twalter23/Beehivescale/Display/HW/Doc design/Photo proto boitier principal.jpeg

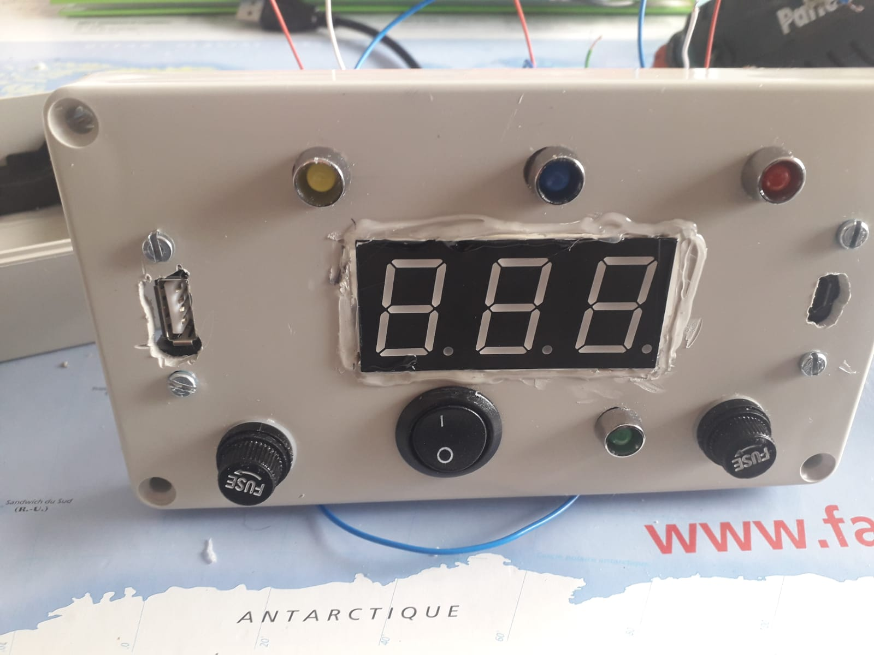
Display/HW/Doc design/Photo proto boitier principal.jpeg
