twalter23/Beehivescale/README.md

# BeehiveScale
Project of a scale for beehive.

The project is splited in two parts, the sensor and the display.
The sensor, also called pocket scale, is installed under the hive and will only be moved if the hive is deplaced. 

The display is a portative "box" with integrated battery and seven segments to display the weight of the hive.
A jack connector on display and sensor permits to connect them and start the communication. 

The sensor send the weight information to the display which set the seven segments accordingly to the received informations.
