twalter23/Beehivescale/Display/HW/Architecture + synoptique/Architecture protection BMS.pptx

µUSBB pour chargeur 5V (500m, 1A)

Protection
Surtension batterie (OVP)

Affichage
- 7 segments
- LED batterie faible
- LED ON

Protection
BMS

BMS
- Charge
- Gestion LED indication

Affichage
- LEDs statut charge

Batterie

Protection
Sous tension batterie (UVP)

X4 Gauge cell (pont de Wheatstone)

Presse étoupe

HX711

- Communication série
- Alimentation

DC/DC
5V

Arduino nano :
- Communication série avec boitier acquisition
- Affichage
- LED batterie faible

USB A

USB A

Arduino nano :
- Communication série avec boitier principal
- Stockage valeurs calibration HX711
- Communication série (émulation) avec HX711

Boitier principal

Boitier acquisition

## Slide 2

BQ2438x
Front end overvoltage and overcurrent protection
