twalter23/Beehivescale/Display/HW/Architecture + synoptique/Synoptique boitier principal.pptx

PANNEAU

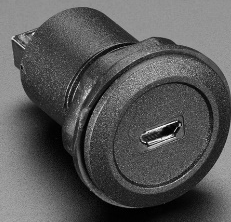
[picture p3: figure]

Socket µUSB B Charger
5V 1A

1A 5x20mm
Fuse IN

3 digits 7 segments display (+ bezel)

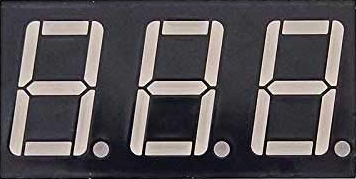
[picture p4: figure]
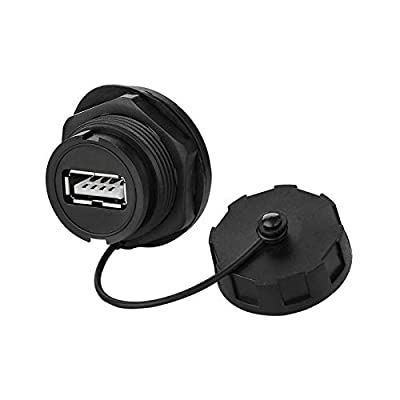
[picture p5: figure]

Socket USB A

ON

Batterie faible

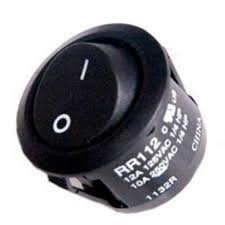
[picture p6: figure]

ON
OFF

200mA 5x20mm
Fuse OUT

En charge

Charge OK

## Slide 2

Connexions inter PANNEAU

CATH_DIG_2

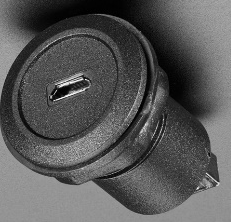
[picture p7: figure]

+5V_IN

+5V_FUSED

+SEG_1

+SEG_8

+5V_BOOST

GND

CATH_DIG_1

CATH_DIG_3

RX

TX

+5V_BOOST_FUSED

VBAT_ON

CMD_LED_CHARGE_OK

CMD_LED_ON

CMD_LED_EN_CHARGE

CMD_LED_BAT_FAIBLE

VBAT

+5V_SUPPLY
