twalter23/Beehivescale/Display/HW/Architecture + synoptique/Synoptique systeme complet.pptx

Boîtier principal :
Affichage, gestion de la batterie

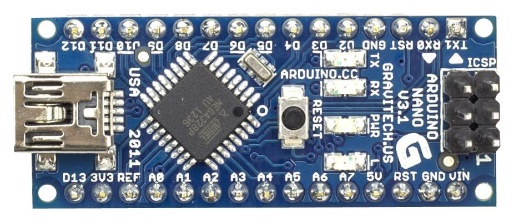
[picture p8: figure]

Comm. Série

Boîtier secondaire:
Un par jeu de capteur
Propre au jeu de capteur car contient les informations de calibration

Comm. Série
(émulée)

µ USB A
Socket

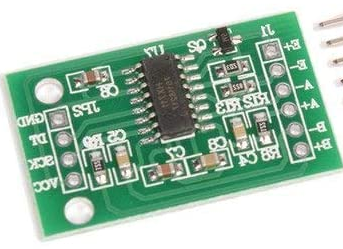
[picture p9: figure]

µ USB B
Socket

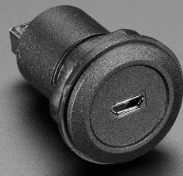
[picture p10: figure]

Câble USB A
mâle mâle
Alim et comm. série

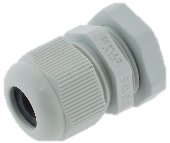
[picture p11: figure]

BMS

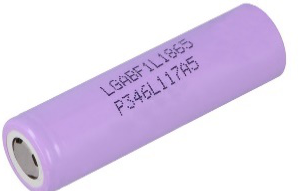
[picture p12: figure]

E+

A-

A+

E-
