twalter23/Beehivescale/Display/Fab/DAS acquisition ruche connectée.docx

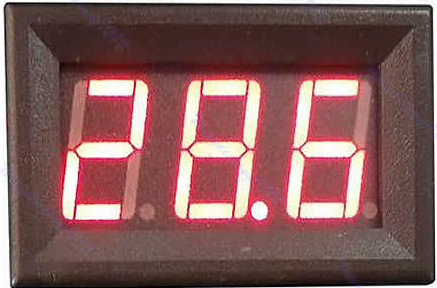
[picture p30: figure]
Hot Sell Tension Panel Meter 3Bit Affichage Numérique Voltmètre Mini 4.5-30V DC DEL
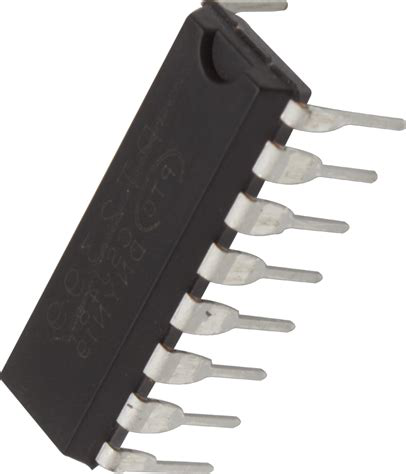
[picture p31: figure]
Integrated Circuit - PT2399, Echo / Delay | Amplified Parts
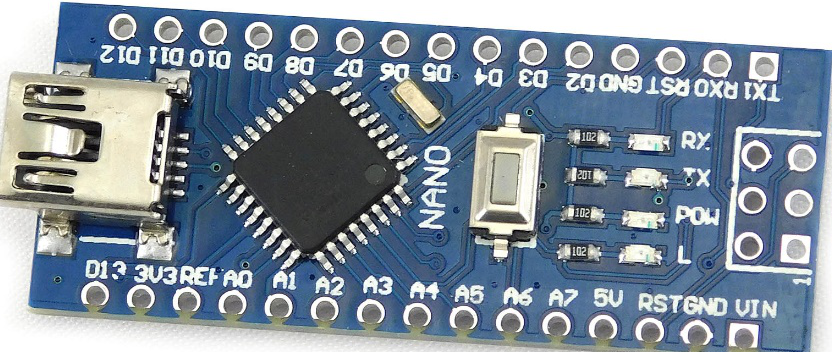
[picture p32: figure]
Nettigo: Klon Arduino Nano V3 ATMega328P + CH340
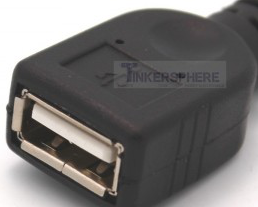
[picture p33: figure]
$3.49 - Female USB Port with Wire Leads - Tinkersphere
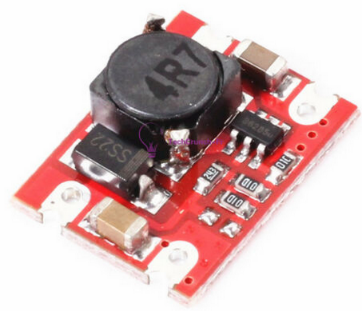
[picture p34: figure]
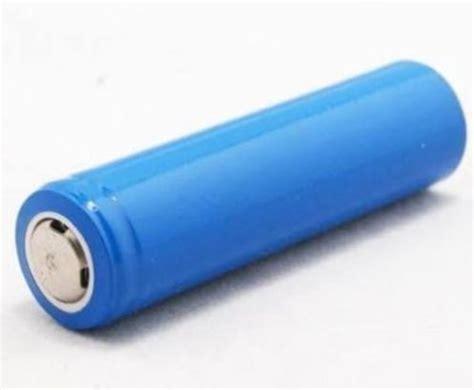
[picture p35: figure]
Lithium 18650 Rechargeable Cell, लिथियम रिचार्जेबल सेल ...
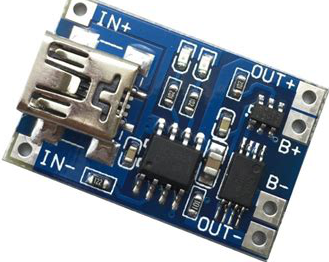
[picture p36: figure]
Other Electronic Components TP4056 1A 5V Lithium Battery ...
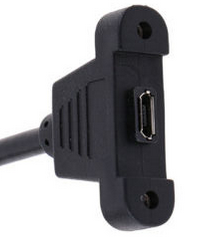
[picture p37: figure]
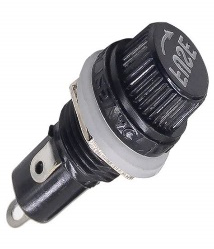
[picture p38: figure]
กระบอกฟิวส์ สำหรับฟิวส์ขนาด 5x20mm Fuse holder 5x20mm | SP ...
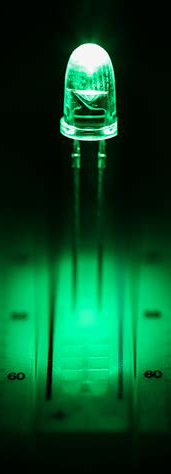
[picture p39: figure]
5mm Green LED - 525 nm - T1 3/4 LED w/ 8 Degree Viewing ...

SN74143
