twalter23/Beehivescale/Sensor/Fab/DAS Capteur.docx

## Perçage :

Presse-étoupe

Connecteur USB panel

## Intérieur du boîtier

6 fils

Connexion :

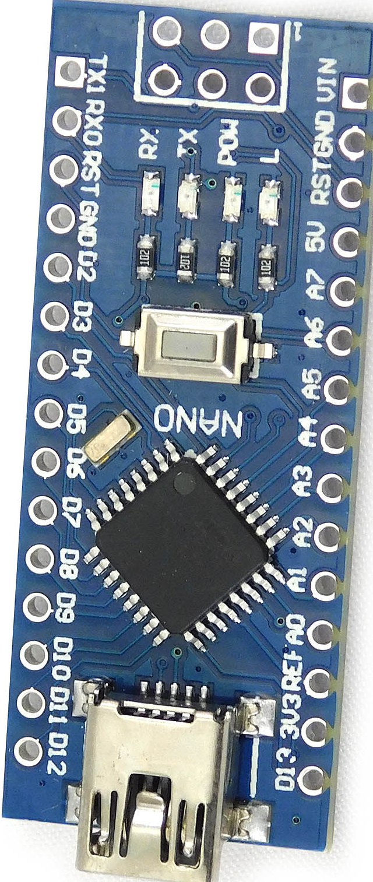
[picture p40: figure]
Nettigo: Klon Arduino Nano V3 ATMega328P + CH340
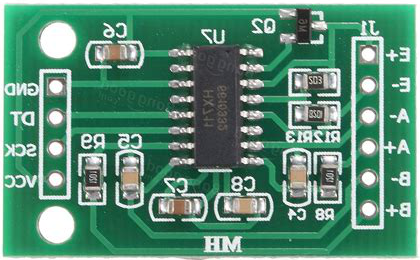
[picture p41: figure]
Buy Dual Channel HX711 Load Cell Amplifier Online at ...
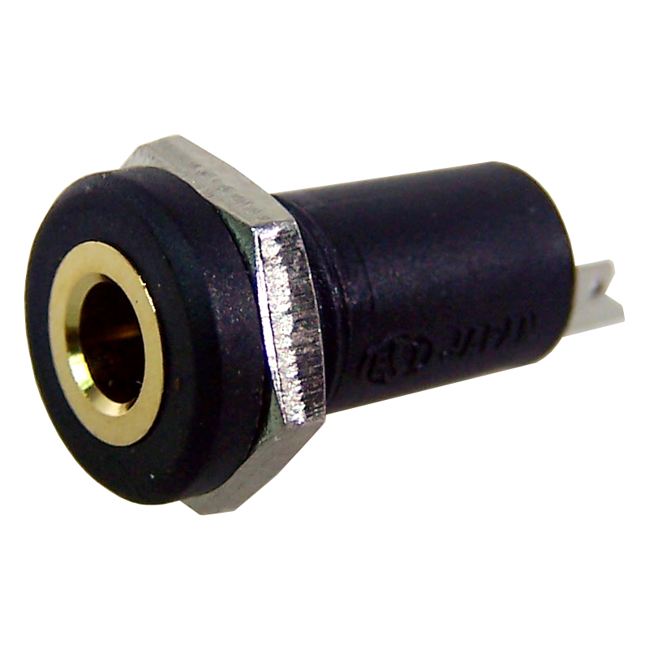
[picture p42: figure]
