twalter23/Beehivescale/Display/Meca/Boitier/PCB/Cotes boitier.docx

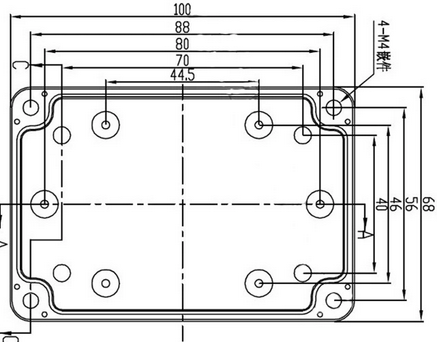
[picture p43: figure]

PCB :
