twalter23/Beehivescale/Display/HW/Doc design/Brochage Arduino.xlsx

Broche | Fonction | Signal
1 | D1/TX | RX
2 | D0/RX | TX
3 | RESET\
4 | GND | GND
5 | D2 | DIG1_BASE
6 | D3 | DIG2_BASE
7 | D4 | DIG3_BASE
8 | D5 | SEG_1
9 | D6 | SEG_2
10 | D7 | SEG_3
11 | D8 | SEG_4
12 | D9 | SEG_5
13 | D10 | SEG_6
14 | D11 | SEG_7
15 | D12 | SEG_8
16 | D13 | CMD_LOW_BAT
17 | 3V3
18 | AREF
19 | A0
20 | A1
21 | A2
22 | A3
23 | A4
24 | A5
25 | A6
26 | A7
27 | +5V | +5V_BOOST
28 | RESET\
29 | GND | GND
30 | VIN
