twalter23/Beehivescale/Display/HW/Doc design/Brochage connecteur carte principale.xlsx

Broche | Signal
1 | +5V_FUSED
2 | LED_EN_CHARGE
3 | LED_CHARGE_OK
4 | LED_LOW_BAT
5 | +5V_BOOST
6 | DIG1
7 | DIG2
8 | DIG3
9
10 | GND
11 | +SEG_A
12 | +SEG_B
13 | +SEG_C
14 | +SEG_D
15 | +SEG_E
16 | +SEG_F
17 | +SEG_G
18 | +SEG_H
19 | RX
20 | TX
