twalter23/Beehivescale/Display/SW/Flowchart code.pdf

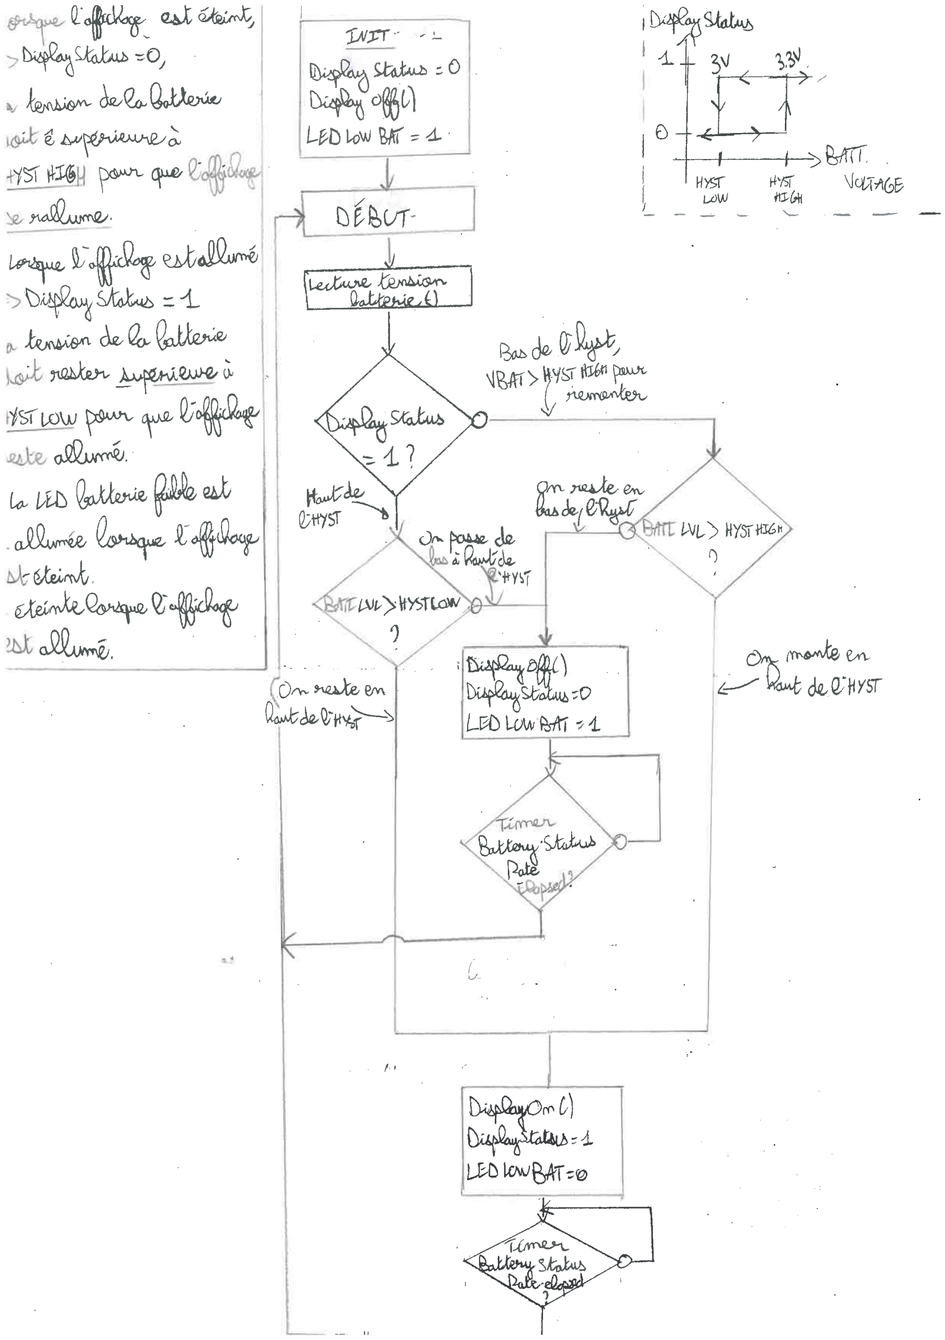
[picture p44: page 1]
