twalter23/Beehivescale/Display/Doc/Photos/Photo 2/WhatsApp Image 2021-04-11 at 21.18.06.jpeg

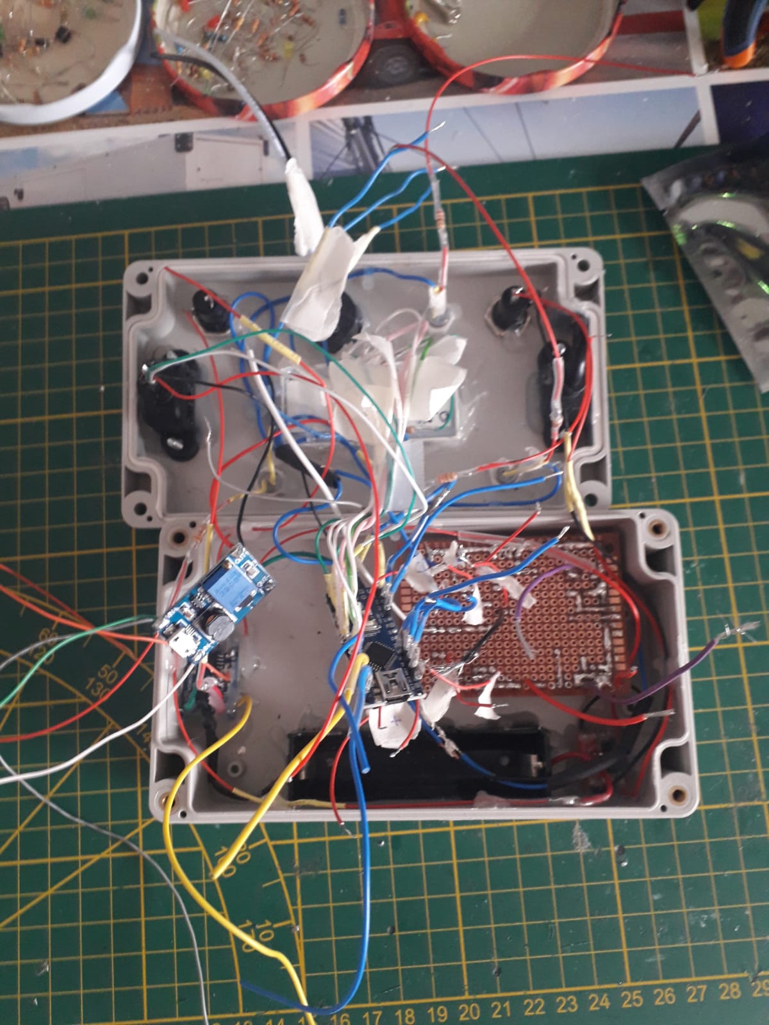
Display/Doc/Photos/Photo 2/WhatsApp Image 2021-04-11 at 21.18.06.jpeg
