twalter23/Beehivescale/Display/Doc/Photos/WhatsApp Image 2021-03-26 at 11.25.21.jpeg

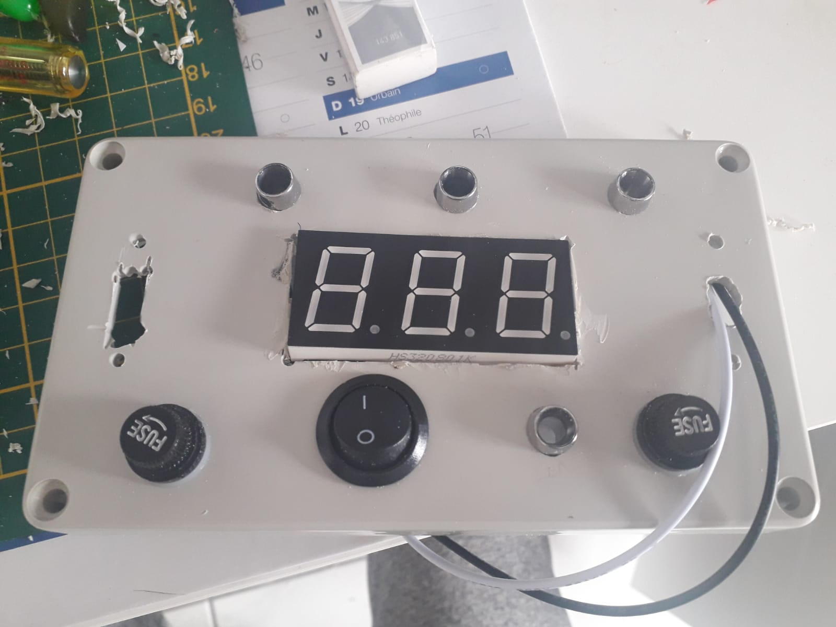
Display/Doc/Photos/WhatsApp Image 2021-03-26 at 11.25.21.jpeg
