twalter23/Beehivescale/Display/Doc/Photos/WhatsApp Image 2021-03-26 at 17.11.53(1).jpeg

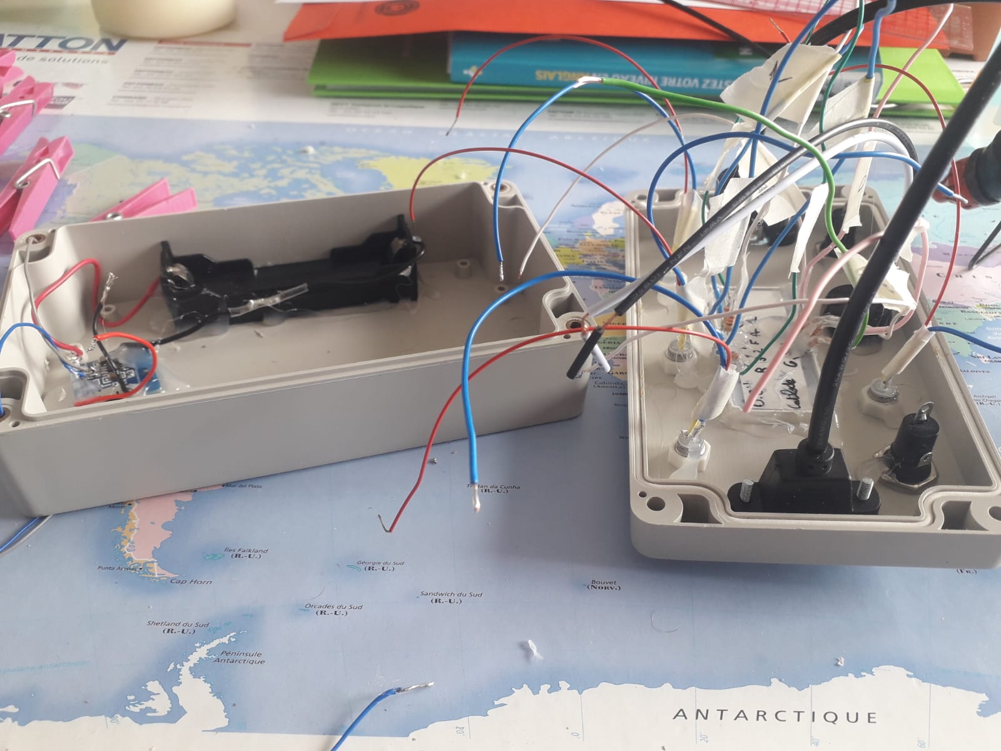
Display/Doc/Photos/WhatsApp Image 2021-03-26 at 17.11.53(1).jpeg
