twalter23/Beehivescale/Display/Fab/Bezel/WhatsApp Image 2021-04-18 at 17.24.22.jpeg

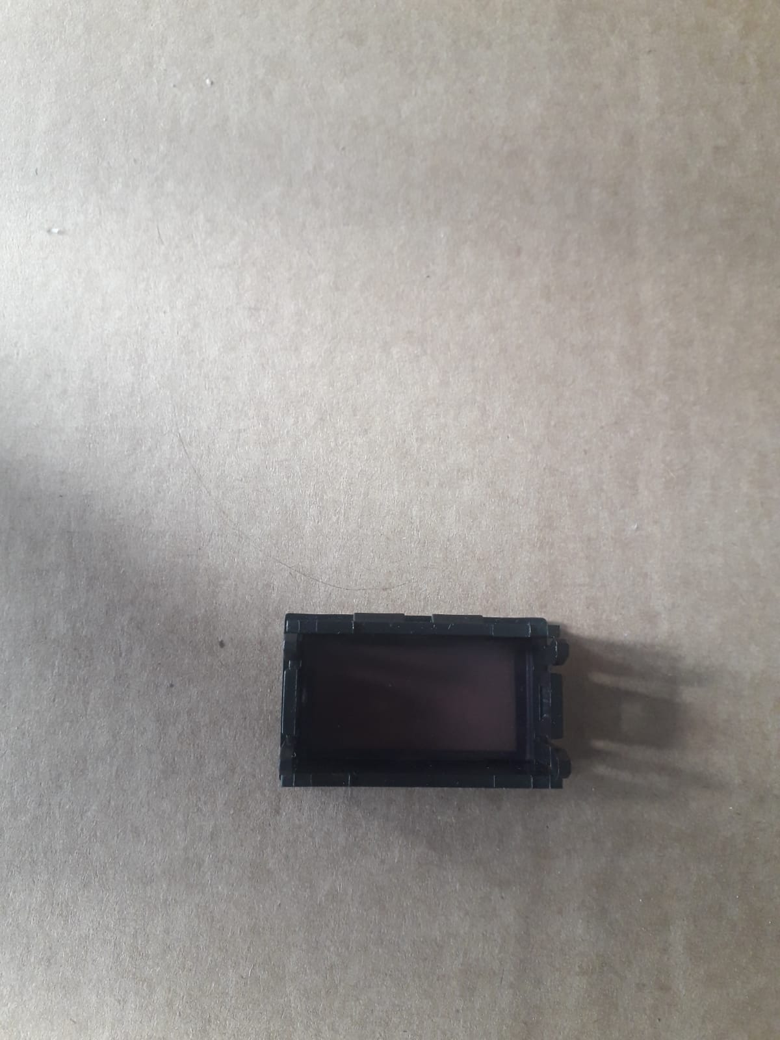
Display/Fab/Bezel/WhatsApp Image 2021-04-18 at 17.24.22.jpeg
