twalter23/Beehivescale/Display/Fab/BOM Acquisition ruche connectée.xlsx

Element | Ref | Fab | Lien | Quantité | Prix unitaire | Prix total
Boite 158mmx90mmx48mm |  |  | https://www.ebay.fr/itm/Plastique-Electrical-Bo%C3%AEtier-Bo%C3%AEte-De-Jonction-%C3%89tui-158mmx90mmx48mm-Gris/392008505112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 | 1 | 9.00 € | 9.00 €
Nano arduino |  |  | https://www.ebay.fr/itm/MINI-USB-Nano-V3-0-ATmega328P-CH340G-5V-16M-Micro-controller-Board-Arduino/263028181552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 | 1 | 4.00 € | 4.00 €
USB Femelle Panel |  |  | https://www.ebay.fr/itm/Panel-Mount-Extension-Cable-USB-2-0-Male-to-Female-Extension-Port-Adapt-fr/293944763372 | 1 | 2.50 € | 2.50 €
LED + BEZEL |  |  |  | 4 | 0.50 € | 2.00 €
Switch rond |  |  | https://www.ebay.fr/itm/10pcs-Black-round-rocker-switch-2-pins-toggle-LED-switch-on-off-control-power/282764631920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 | 1 | 1.00 € | 1.00 €
µ USB femelle panel |  |  | https://www.ebay.fr/itm/Micro-USB-2-0-Male-To-Female-Extension-Cable-With-Screws-Panel-Mount-Hole-rd/154101443311 | 1 | 2.50 € | 2.50 €
Afficheur 7 segments |  |  | https://www.ebay.fr/itm/0-56-2-Wire-AC70V-500V-DC5V-120V-Voltmeter-Voltage-Panel-Ammeter-Meter-LED/113556731141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 | 1 | 2.50 € | 2.50 €
Fuse holder + fuse |  |  |  | 2 | 0.50 € | 1.00 €
Pile Li-Ion |  |  | https://www.ebay.fr/itm/BATTERIE-Liitokala-3400-mAh-NCR18650B/324418871803 | 1 | 6.00 € | 6.00 €
TP40-56 |  |  | https://www.ebay.fr/itm/2x-TP4056-1A-5V-Li-ion-Battery-Charger-Module-USB-Board-Electronic-Component-US/311904046261 | 1 | 1.00 € | 1.00 €
Li-Ion holder |  |  | https://www.ebay.fr/itm/5pcs-1-Slot-Storage-Box-Holder-Case-For-1x-Li-ion-18650-3-7V-Battery-With-Pin/352161030364 | 1 | 1.00 € | 1.00 €
Divers composants traversants |  |  |  | 1 | 1.00 € | 1.00 €
Boost DC DC |  |  |  | 1 | 2.00 € | 2.00 €
Cable USB A male male |  |  |  | 1 | 2.00 € | 2.00 €
 |  |  |  |  |  | 0.00 €
 |  |  |  |  |  | 0.00 €
 |  |  |  |  |  | 0.00 €
Somme |  |  |  |  |  | 37.50 €
