twalter23/Beehivescale/Sensor/Fab/BOM Capteur.xlsx

Element | Ref | Fab | Lien | Quantité | Prix unitaire | Prix total
4 Cell LOAD + HX711 amplifier |  |  | https://www.ebay.fr/itm/4pcs-Weight-Sensor-50kg-Load-Cell-Half-bridge-Strain-HX711-AD-Amplifier-Module/182899653153 | 1 | 6.00 € | 6.00 €
Cable USB | 1243/2C SL005 | Alpha Wire | https://fr.rs-online.com/web/p/cables-industriels-multipaires-torsadees/1871899/ | 2 | 2.15 € | 4.30 €
Boite 100*60*25 |  |  | https://www.ebay.fr/itm/5x-en-plastique-boitier-de-projet-de-boite-de-projet-electronique-100x60x25mm-SL/353270796402 | 1 | 2.00 € | 2.00 €
USB Femelle Panel |  |  | https://www.ebay.fr/itm/Panel-Mount-Extension-Cable-USB-2-0-Male-to-Female-Extension-Port-Adapt-fr/293944763372 | 1 | 2.50 € | 2.50 €
Nano arduino |  |  | https://www.ebay.fr/itm/MINI-USB-Nano-V3-0-ATmega328P-CH340G-5V-16M-Micro-controller-Board-Arduino/263028181552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 | 1 | 4.00 € | 4.00 €
Presse étoupe |  |  | https://www.ebay.fr/itm/10PCS-4-8-mm-Black-Nylon-Electric-Cable-Waterproof-M14-1-5-mm-Cable-Gland/271396115700 | 1 | 0.50 € | 0.50 €
Visse M3*12 |  |  |  | 2 |  | 0.00 €
Loctite |  |  |  |  |  | 0.00 €
Support plastique capteur |  |  |  | 4 |  | 0.00 €
 |  |  |  |  |  | 0.00 €
 |  |  |  |  |  | 0.00 €
 |  |  |  |  |  | 0.00 €
 |  |  |  |  |  | 0.00 €
 |  |  |  |  |  | 0.00 €
 |  |  |  |  |  | 0.00 €
 |  |  |  |  |  | 0.00 €
 |  |  |  |  |  | 0.00 €
Somme |  |  |  |  |  | 19.30 €
