twalter23/Beehivescale/Display/Meca/Boitier/Face avant/Avec cotes/USB A/Face avant.dxf

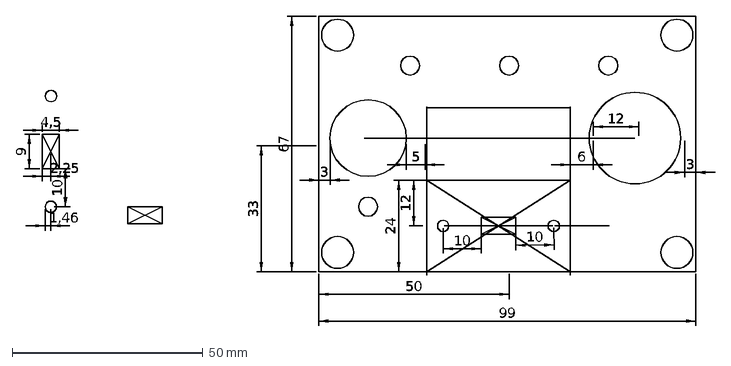
[picture p59: CAD file, 2023-06-10]
Display/Meca/Boitier/Face avant/Avec cotes/USB A/Face avant.dxf
67
99
50
33
9
4,5
10
1,46
2,25
12
3
5
6
24
