twalter23/Beehivescale/Display/Meca/Boitier/Face avant/Sans cotes/Jack/Face avant sans cotes.dxf

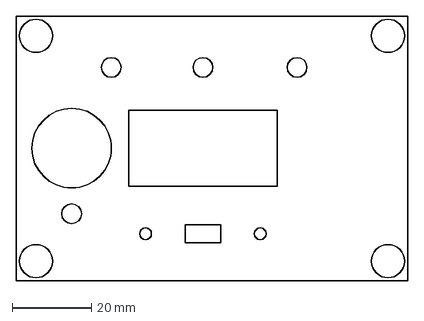
[picture p60: CAD file, 2023-06-10]
Display/Meca/Boitier/Face avant/Sans cotes/Jack/Face avant sans cotes.dxf
99.0 x 67.0 mm
