twalter23/Beehivescale/Display/Meca/Boitier/PCB/#LIBRECAD.dxf

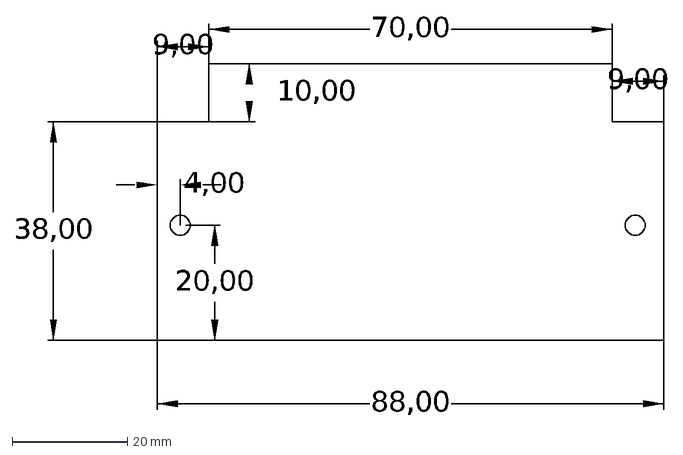
[picture p62: CAD file, 2023-06-10]
Display/Meca/Boitier/PCB/#LIBRECAD.dxf
20,00
88,00
38,00
9,00
10,00
70,00
4,00
