twalter23/Beehivescale/Sensor/Meca/x1cell.stl

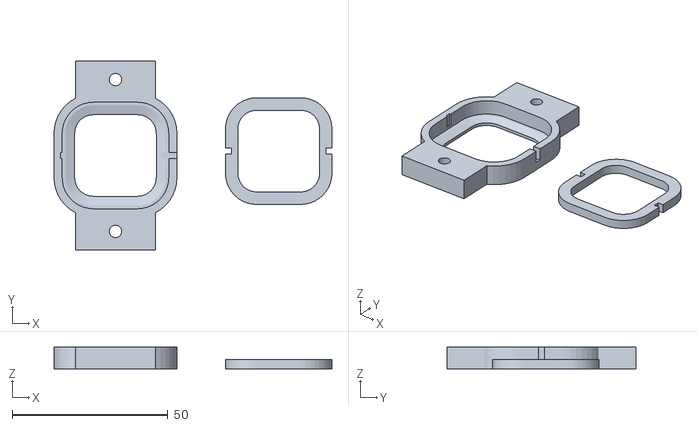
[picture p63: CAD file, 2023-06-10]
Sensor/Meca/x1cell.stl
89.2 x 60.7 x 7.00
