twalter23/Beehivescale/Sensor/Meca/x4cell.3mf

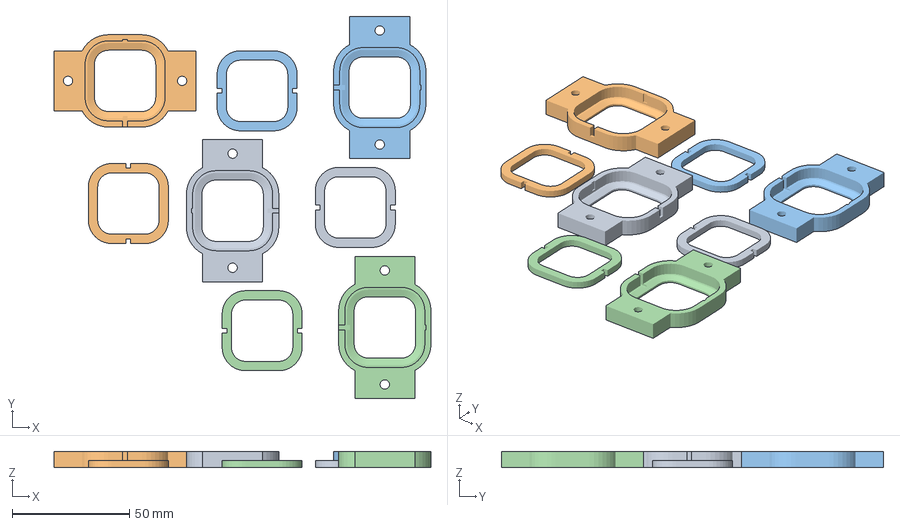
[picture p64: CAD file, 2023-06-10]
Sensor/Meca/x4cell.3mf
161.0 x 163.2 x 7.00 mm
50kgLoadcell-VersionF.stl
50kgLoadcell-VersionF.stl(1)
50kgLoadcell-VersionF.stl(2)
50kgLoadcell-VersionF.stl(4)
