twalter23/Beehivescale/(list of files, cad)

Other CAD files:
Display/Meca/Boitier/PCB/LIBRECAD.dxf
Sensor/Meca/x4cell.stl
