twalter23/Beehivescale/Display/HW/Architecture protection BMS/Architecture protection BMS.pdf

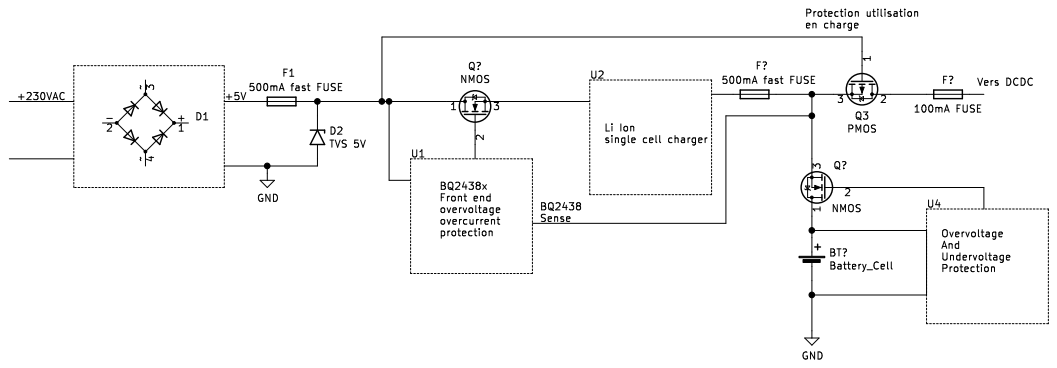
[picture p65: page 1]
