twalter23/Beehivescale/Display/HW/CAO/V01/OUTPUT SCH/Carte boitier principal V01-draft01.pdf

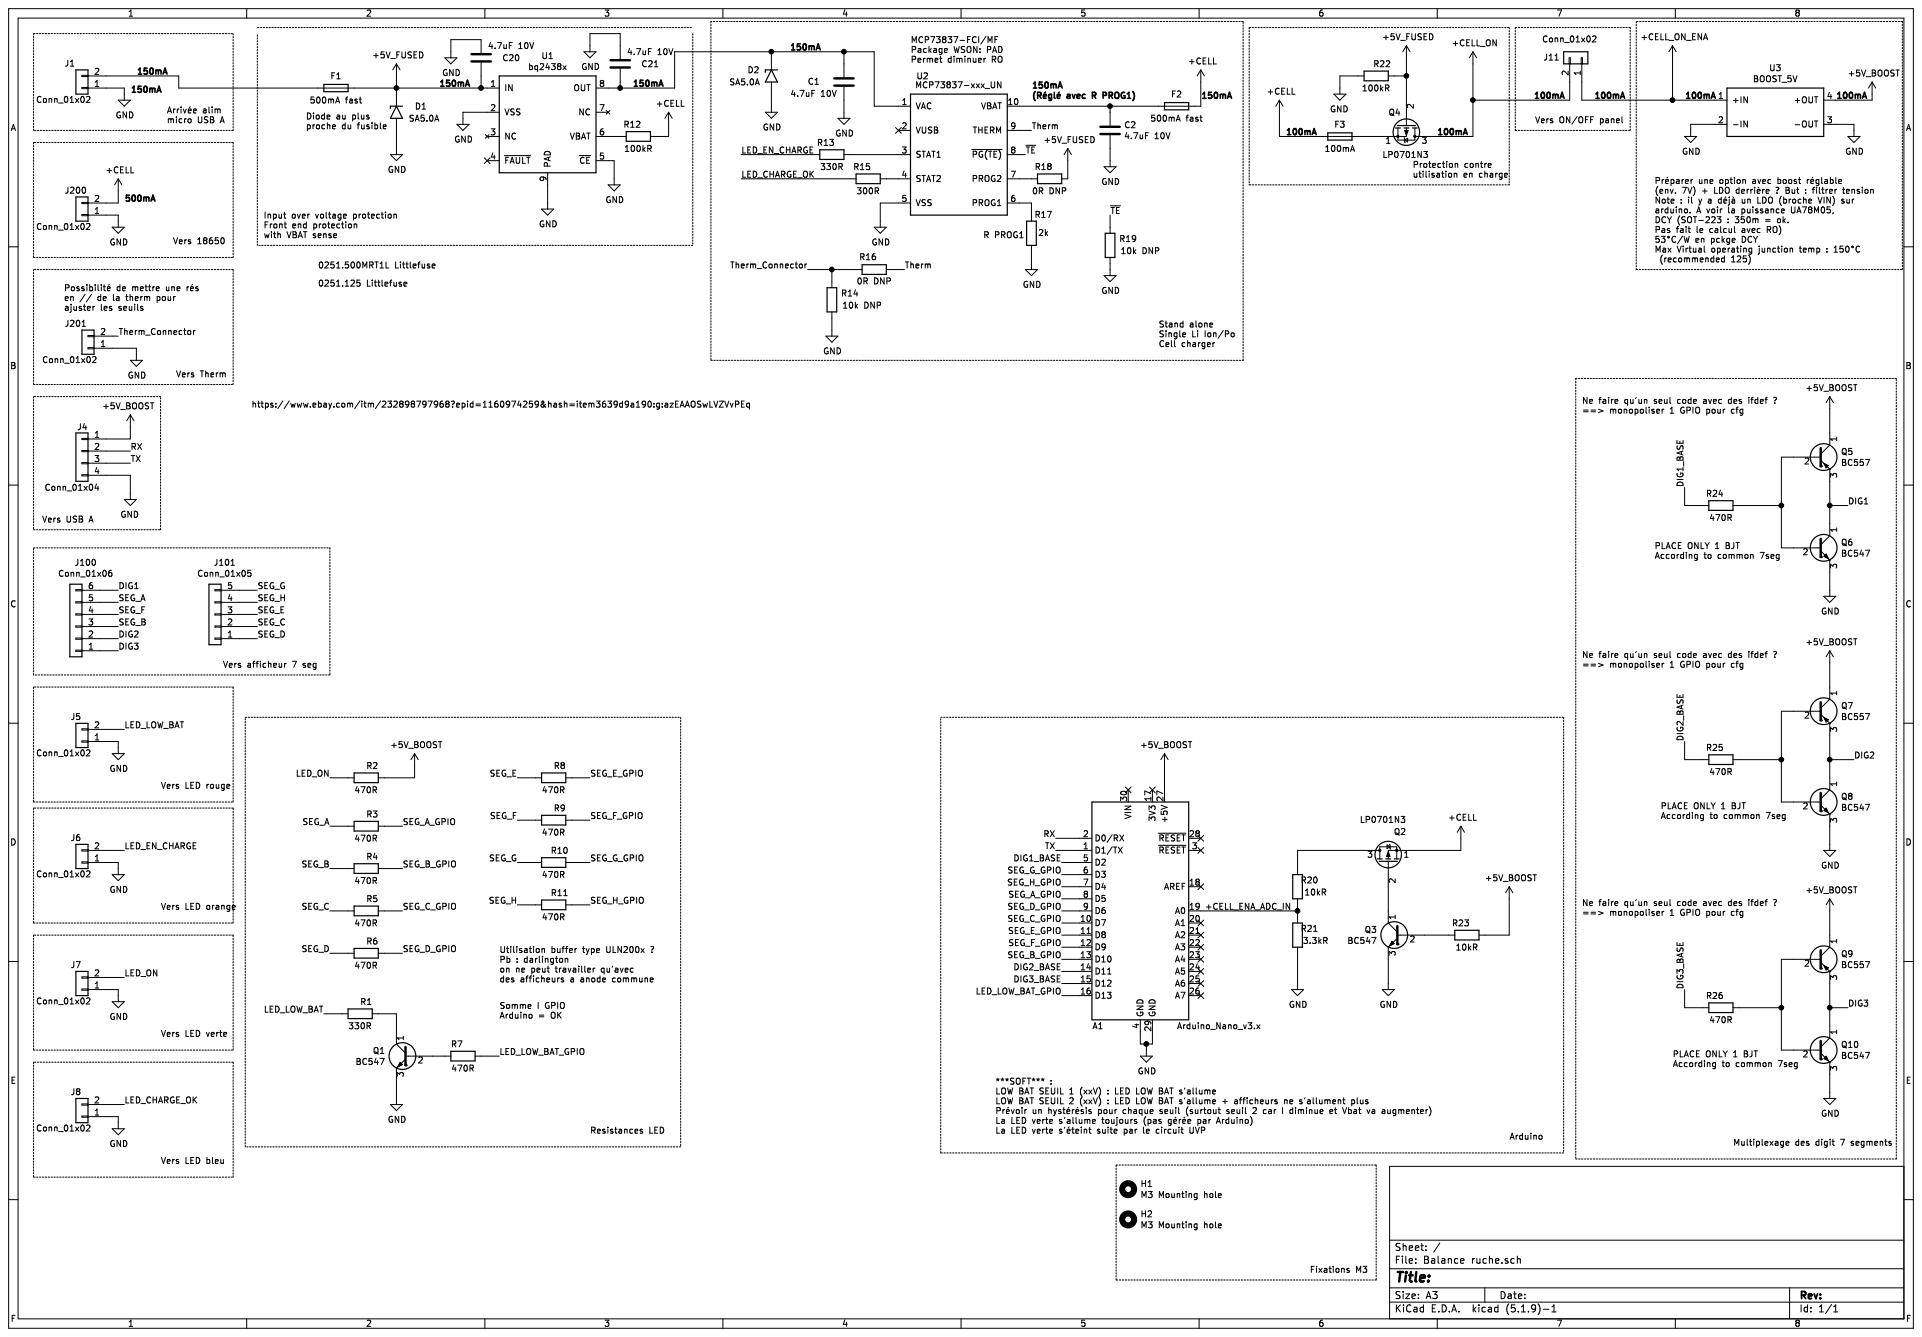
[picture p66: page 1]
