twalter23/Beehivescale/Display/HW/CAO/V01/Balance ruche.kicad_pcb

## KiCad design Display/HW/CAO/V01/Balance ruche.kicad_pcb (2023-06-10)

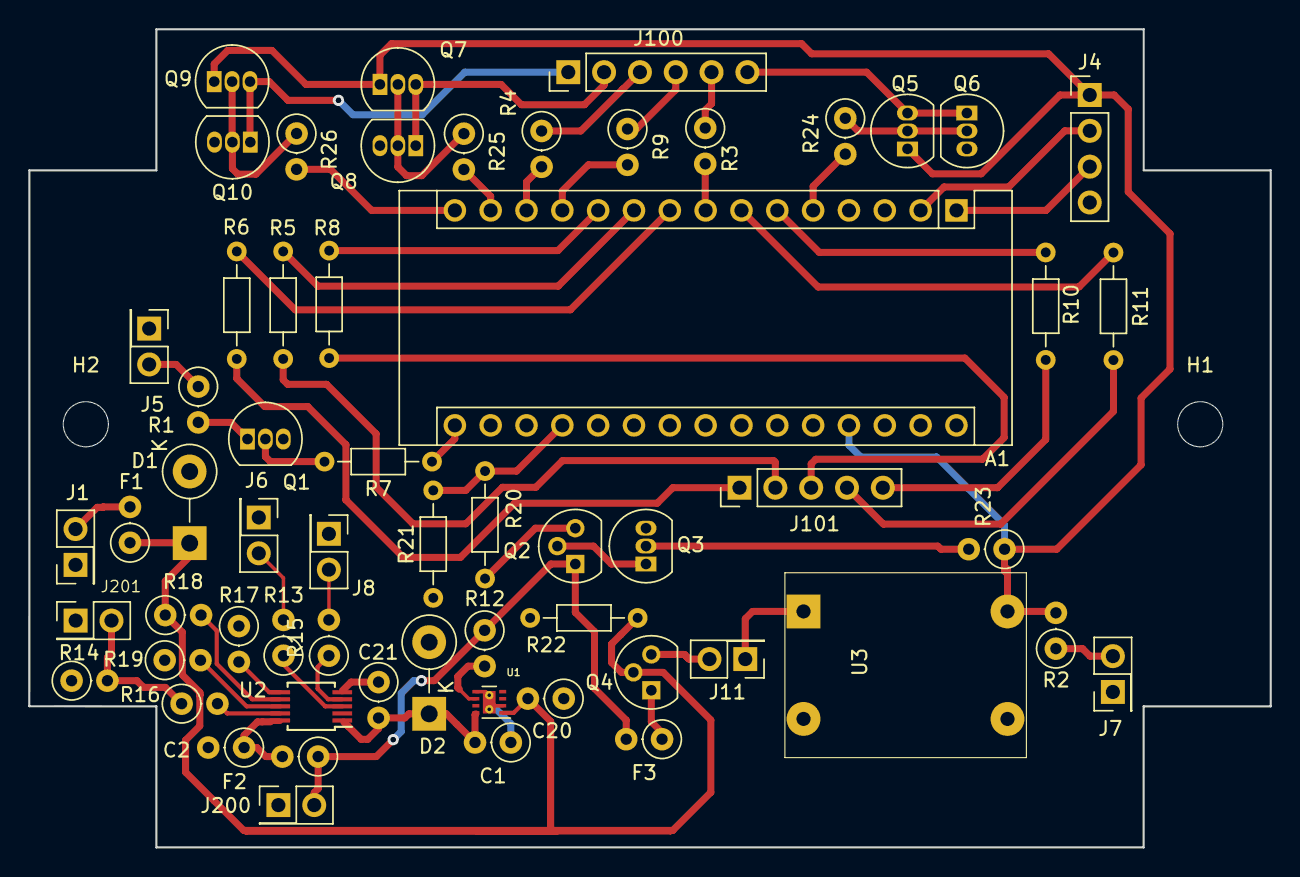
[picture p67: board Balance ruche.kicad_pcb from above]

Board: 2 copper layers, 88.0 x 58.0 mm, 62 parts (0 on the bottom side), 56 nets.

Parts:
A1: Arduino_Nano_v3.x; Arduino_Nano
C1, C2, C20, C21: 4.7uF 10V; R_Axial_DIN0207_L6.3mm_D2.5mm_P2.54mm_Vertical
D1, D2: SA5.0A; D_DO-15_P5.08mm_Vertical_KathodeUp
F1, F2: 500mA fast; R_Axial_DIN0207_L6.3mm_D2.5mm_P2.54mm_Vertical
F3: 100mA; R_Axial_DIN0207_L6.3mm_D2.5mm_P2.54mm_Vertical
H1, H2: M3 Mounting hole; MountingHole_3.2mm_M3
J1, J5, J6, J7, J8, J11, J200, J201: Conn_01x02; PinHeader_2x01_P2.54mm_Vertical
J4: Conn_01x04; PinHeader_1x04_P2.54mm_Vertical
J100: Conn_01x06; PinHeader_1x06_P2.54mm_Vertical
J101: Conn_01x05; PinHeader_1x05_P2.54mm_Vertical
Q1, Q3, Q6, Q8, Q10: BC547; TO-92_Inline
Q2, Q4: LP0701N3; TO-92
Q5, Q7, Q9: BC557; TO-92_Inline
R1, R13: 330R; R_Axial_DIN0207_L6.3mm_D2.5mm_P2.54mm_Vertical
R2, R3, R4, R9, R24, R25, R26: 470R; R_Axial_DIN0207_L6.3mm_D2.5mm_P2.54mm_Vertical
R5, R6, R7, R8, R10, R11: 470R; R_Axial_DIN0204_L3.6mm_D1.6mm_P7.62mm_Horizontal
R12: 100kR; R_Axial_DIN0207_L6.3mm_D2.5mm_P2.54mm_Vertical
R14, R19: 10k DNP; R_Axial_DIN0207_L6.3mm_D2.5mm_P2.54mm_Vertical
R15: 300R; R_Axial_DIN0207_L6.3mm_D2.5mm_P2.54mm_Vertical
R16, R18: 0R DNP; R_Axial_DIN0207_L6.3mm_D2.5mm_P2.54mm_Vertical
R17: 2k; R_Axial_DIN0207_L6.3mm_D2.5mm_P2.54mm_Vertical
R20: 10kR; R_Axial_DIN0204_L3.6mm_D1.6mm_P7.62mm_Horizontal
R21: 3.3kR; R_Axial_DIN0204_L3.6mm_D1.6mm_P7.62mm_Horizontal
R22: 100kR; R_Axial_DIN0204_L3.6mm_D1.6mm_P7.62mm_Horizontal
R23: 10kR; R_Axial_DIN0207_L6.3mm_D2.5mm_P2.54mm_Vertical
U1: bq2438x; WSON-8-1EP_2x2mm_P0.5mm_EP0.9x1.6mm_ThermalVias
U2: MCP73837-xxx_UN; MSOP-10_3x3mm_P0.5mm
U3: BOOST_5V; AS19

Connections:
+5V_BOOST: A1.27, J4.1, Q5.1, Q7.1, Q9.1, R2.2, R23.1, U3.4
+5V_FUSED: C20.2, D1.1, F1.1, Q4.2, R18.1, R22.2, U1.1
+CELL: F2.1, F3.2, J200.2, Q2.1, R12.1
+CELL_ON: J11.2, Q4.3
+CELL_ON_ENA: J11.1, U3.1
/+CELL_ENA_ADC_IN: A1.19, R20.1, R21.2
/DIG1: J100.6, Q5.3, Q6.1
/DIG1_BASE: A1.5, R24.2
/DIG2: J100.2, Q7.3, Q8.1
/DIG2_BASE: A1.14, R25.2
/DIG3: J100.1, Q9.3, Q10.1
/DIG3_BASE: A1.15, R26.2
/LED_CHARGE_OK: J8.2, R15.2
/LED_EN_CHARGE: J6.2, R13.2
/LED_LOW_BAT: J5.2, R1.1
/LED_LOW_BAT_GPIO: A1.16, R7.1
/LED_ON: J7.2, R2.1
/RX: A1.2, J4.2
/SEG_A: J100.5, R3.1
/SEG_A_GPIO: A1.8, R3.2
/SEG_B: J100.3, R4.1
/SEG_B_GPIO: A1.13, R4.2
/SEG_C: J101.2, R5.1
/SEG_C_GPIO: A1.10, R5.2
/SEG_D: J101.1, R6.1
/SEG_D_GPIO: A1.9, R6.2
/SEG_E: J101.3, R8.1
/SEG_E_GPIO: A1.11, R8.2
/SEG_F: J100.4, R9.1
/SEG_F_GPIO: A1.12, R9.2
/SEG_G: J101.5, R10.1
/SEG_G_GPIO: A1.6, R10.2
/SEG_H: J101.4, R11.1
/SEG_H_GPIO: A1.7, R11.2
/TX: A1.1, J4.3
/Therm: R16.2, U2.9
/Therm_Connector: J201.2, R14.2, R16.1
/~TE~: R19.2, U2.8
GND: A1.4, A1.29, C1.1, C2.2, C20.1, C21.1, D1.2, D2.2, J1.1, J4.4, J5.1, J6.1, J7.1, J8.1, J200.1, J201.1, Q1.3, Q3.3, Q6.3, Q8.3, Q10.3, R14.1, R17.1, R19.1, R21.1, R22.1, U1.2, U1.5, U1.9, U2.5, U3.2, U3.3
unnamed: C1.2, C21.2, D2.1, U1.8, U2.1
unnamed: C2.1, F2.2, U2.10
unnamed: F1.2, J1.2
unnamed: F3.1, Q4.1
unnamed: Q1.1, R1.2
unnamed: Q1.2, R7.2
unnamed: Q2.2, Q3.1
unnamed: Q2.3, R20.2
unnamed: Q3.2, R23.2
unnamed: Q5.2, Q6.2, R24.1
unnamed: Q7.2, Q8.2, R25.1
unnamed: Q9.2, Q10.2, R26.1
unnamed: R12.2, U1.6
unnamed: R13.1, U2.3
unnamed: R15.1, U2.4
unnamed: R17.2, U2.6
unnamed: R18.2, U2.7
