twalter23/Beehivescale/Display/HW/Architecture protection BMS/Architecture protection BMS.sch

## KiCad design Display/HW/Architecture protection BMS/Architecture protection BMS.sch (2023-06-10)

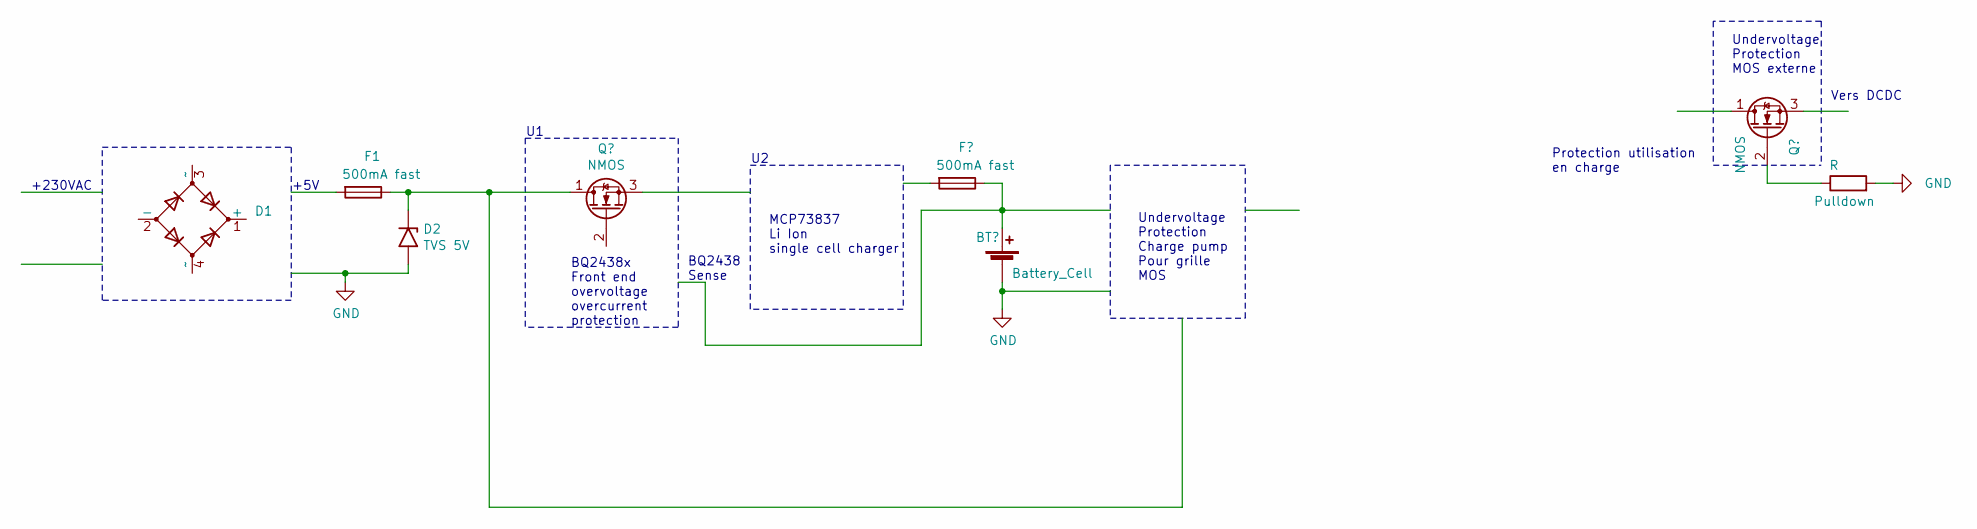
[picture p68: schematic Architecture protection BMS.sch]

Parts:
D1: D_Bridge_+-AA
D2: TVS 5V; D_SMB
F1: 500mA fast
Pulldown: R

Connections:
GND: D2.2 (A2), Pulldown.2
unnamed: D2.1 (A1), F1.1

Notes on the sheet:
+230VAC
+5V
BQ2438x Front end overvoltage overcurrent protection
MCP73837 Li Ion single cell charger
BQ2438 Sense
Protection utilisation en charge
Undervoltage Protection Charge pump Pour grille MOS
Vers DCDC
Undervoltage Protection MOS externe
