twalter23/Beehivescale/Sensor/SW/ReadAndWrite/ReadWeighAndWriteItOnSerialPort/ReadWeighAndWriteItOnSerialPort.ino

/*
   -------------------------------------------------------------------------------------
   HX711_ADC
   Arduino library for HX711 24-Bit Analog-to-Digital Converter for Weight Scales
   Olav Kallhovd sept2017
   -------------------------------------------------------------------------------------
*/

/*
   This example file shows how to calibrate the load cell and optionally store the calibration
   value in EEPROM, and also how to change the value manually.
   The result value can then later be included in your project sketch or fetched from EEPROM.

   To implement calibration in your project sketch the simplified procedure is as follow:
       LoadCell.tare();
       //place known mass
       LoadCell.refreshDataSet();
       float newCalibrationValue = LoadCell.getNewCalibration(known_mass);
*/

#include <HX711_ADC.h>
#if defined(ESP8266)|| defined(ESP32) || defined(AVR)
#include <EEPROM.h>
#endif

#define TARVALUE 8740401
#define CALVALUE 15.78


//pins:
const int HX711_dout = 2; //mcu > HX711 dout pin
const int HX711_sck = 3; //mcu > HX711 sck pin

//HX711 constructor:
HX711_ADC LoadCell(HX711_dout, HX711_sck);

const int calVal_eepromAdress = 0;
int raw;
unsigned long t = 0;

void setup() {
  Serial.begin(57600); delay(10);
  Serial.println();
  Serial.println("Starting...");

  LoadCell.begin();
  unsigned long stabilizingtime = 3000; // preciscion right after power-up can be improved by adding a few seconds of stabilizing time
  boolean _tare = false; //set this to false if you don't want tare to be performed in the next step
  LoadCell.start(stabilizingtime, _tare);
  if (LoadCell.getTareTimeoutFlag() || LoadCell.getSignalTimeoutFlag()) {
    Serial.println("Timeout, check MCU>HX711 wiring and pin designations");
    while (1);
  }
  else {
    LoadCell.setCalFactor(CALVALUE); // user set calibration value (float), initial value 1.0 may be used for this sketch
    LoadCell.setTareOffset(TARVALUE); //set offset
    Serial.println("Startup is complete");
  }
  while (!LoadCell.update());
}

void loop() {
  static boolean newDataReady = 0;
  const int serialPrintInterval = 500; //increase value to slow down serial print activity

  // check for new data/start next conversion:
  if (LoadCell.update()) 
  {newDataReady = true;}

  // get smoothed value from the dataset:
  if (newDataReady) {
    if (millis() > (t + serialPrintInterval)) {
      raw = (LoadCell.getData()/100);
      Serial.write(raw >> 8);
      Serial.write(raw & 0xFF);
      newDataReady = 0;
      t = millis();
    }
  }
}
